bstrobel/fmtransmitter/pcb/FMTransmitterRaspi/FMTransmitterRaspi.kicad_pcb

## KiCad design pcb/FMTransmitterRaspi/FMTransmitterRaspi.kicad_pcb (2026-10-04)

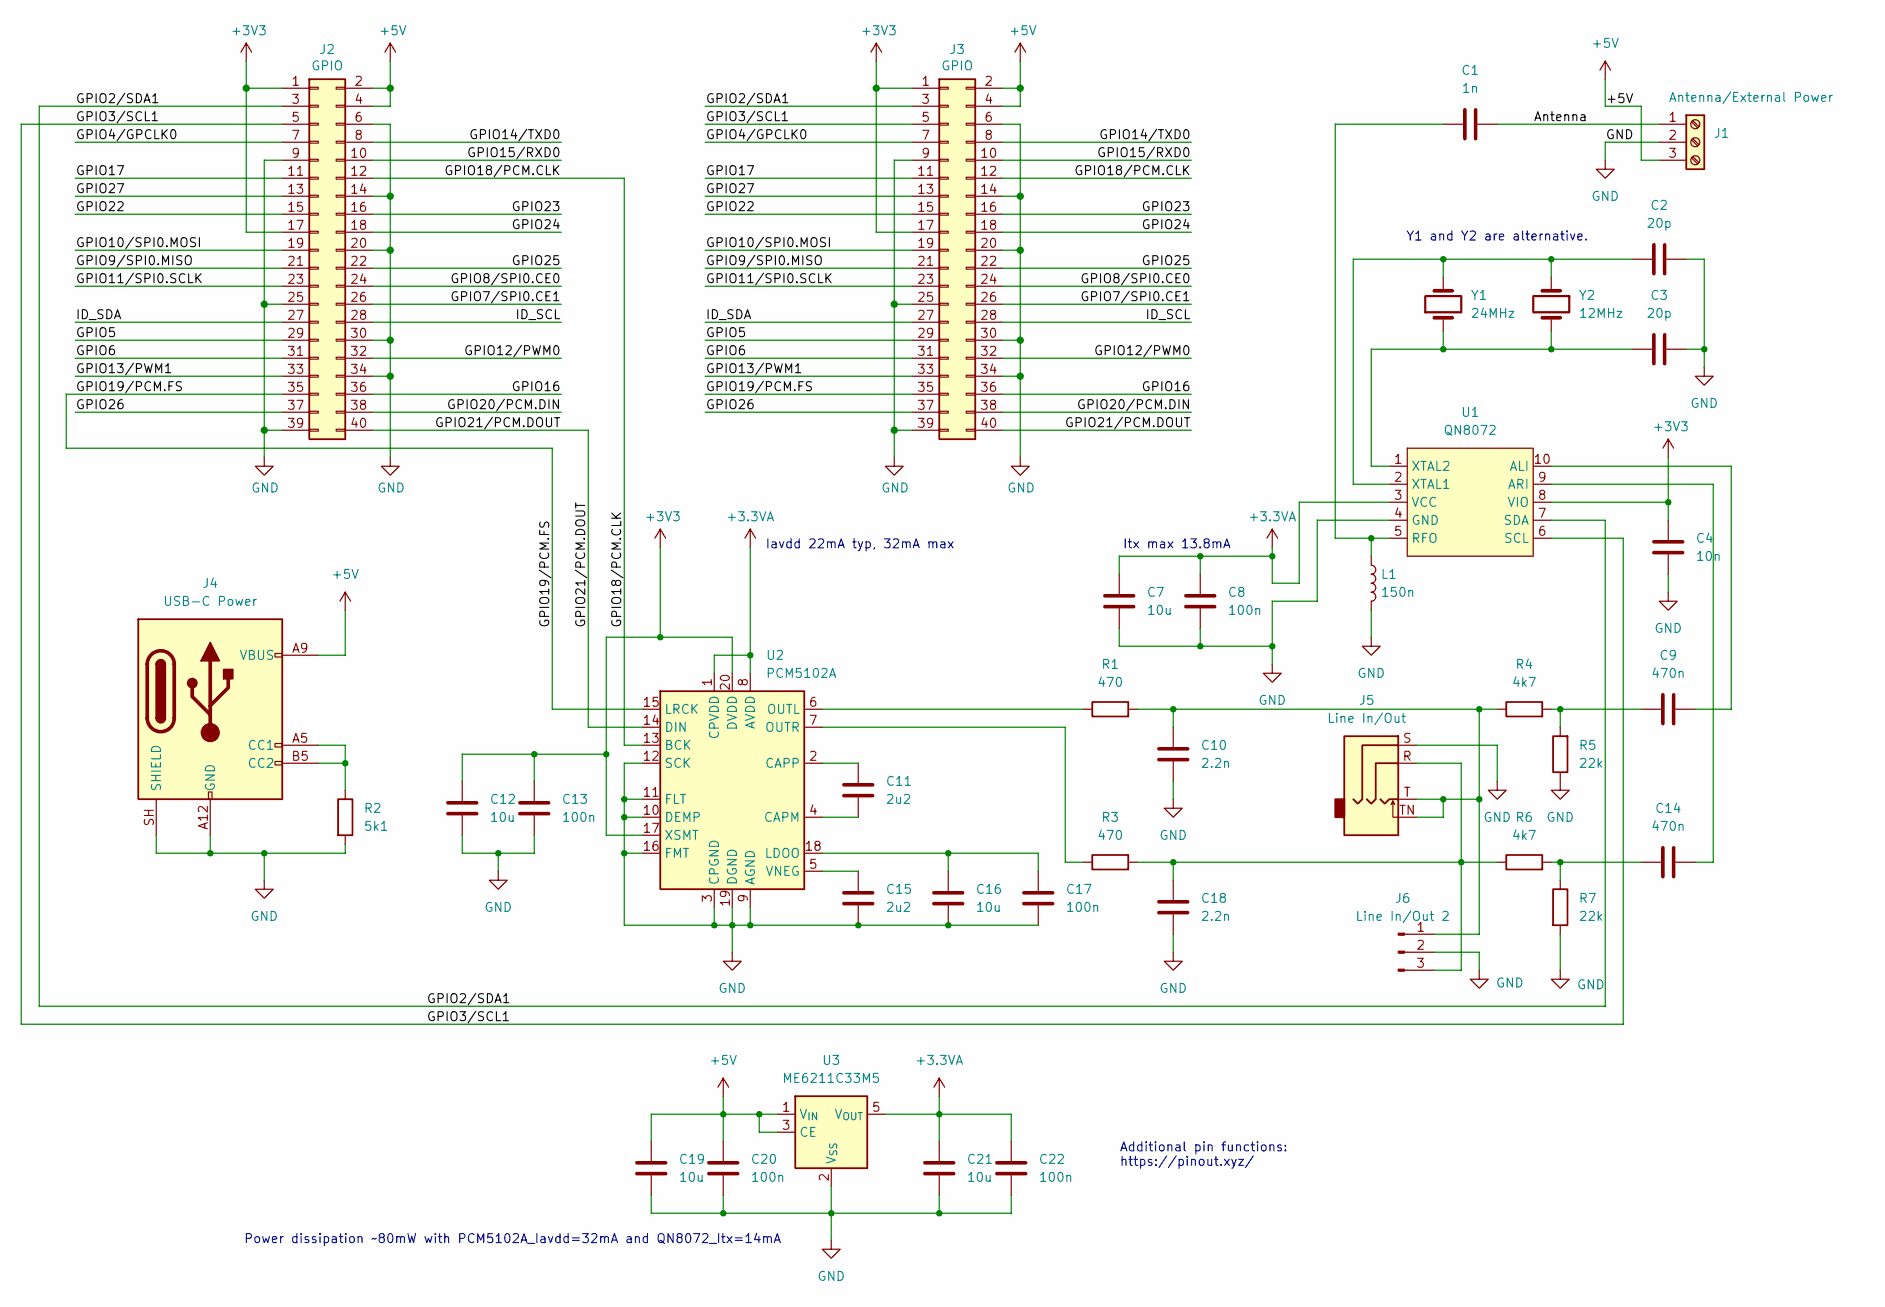
[picture p1: schematic FMTransmitterRaspi.kicad_sch]

Parts:
C1: 1n; C_0603_1608Metric_Pad1.08x0.95mm_HandSolder
C2, C3: 20p; C_0603_1608Metric_Pad1.08x0.95mm_HandSolder
C4: 10n; C_0603_1608Metric_Pad1.08x0.95mm_HandSolder
C7, C12, C16: 10u; C_0603_1608Metric_Pad1.08x0.95mm_HandSolder
C8, C13, C17, C20, C22: 100n; C_0603_1608Metric_Pad1.08x0.95mm_HandSolder
C9, C14: 470n; C_Rect_L7.2mm_W3.5mm_P5.00mm
C10, C18: 2.2n; C_Rect_L9.0mm_W2.7mm_P7.50mm_MKT
C11, C15: 2u2; C_0603_1608Metric_Pad1.08x0.95mm_HandSolder
C19, C21: 10u; C_0805_2012Metric_Pad1.18x1.45mm_HandSolder
J1: Antenna/External Power; TerminalBlock_MaiXu_MX126-5.0-03P_1x03_P5.00mm
J2: GPIO; PinSocket_2x20_P2.54mm_Vertical
J3: GPIO; PinHeader_2x20_P2.54mm_Vertical
J4: USB-C Power; USB_C_Receptacle_HRO_TYPE-C-31-M-17
J5: Line In/Out; Jack_3.5mm_PJ327A_Horizontal
J6: Line In/Out 2; PinHeader_1x03_P2.54mm_Vertical
L1: 150n; L_0805_2012Metric_Pad1.05x1.20mm_HandSolder
R1, R3: 470; R_0603_1608Metric_Pad0.98x0.95mm_HandSolder
R2: 5k1; R_0603_1608Metric_Pad0.98x0.95mm_HandSolder
R4, R6: 4k7; R_0603_1608Metric_Pad0.98x0.95mm_HandSolder
R5, R7: 22k; R_0603_1608Metric_Pad0.98x0.95mm_HandSolder
U1: QN8072; MSOP-10_3x3mm_P0.5mm
U2: PCM5102A; TSSOP-20_4.4x6.5mm_P0.65mm
U3: ME6211C33M5; SOT-23-5
Y1: 24MHz; Crystal_HC18-U_Vertical
Y2: 12MHz; Crystal_DS15_D1.5mm_L5.0mm_Horizontal_1EP_style1

Connections:
+3.3VA: C7.1, C8.1, C21.1, C22.1, U1.3 (VCC), U2.1 (CPVDD), U2.8 (AVDD), U3.5 (V_{OUT})
+3V3: C4.1, C12.1, C13.1, J2.1, J2.17, J3.1, J3.17, U1.8 (VIO), U2.17 (XSMT), U2.20 (DVDD)
+5V: C19.1, C20.1, J1.3, J2.2, J2.4, J3.2, J3.4, J4.A9 (VBUS), J4.B9 (VBUS), U3.1 (V_{IN}), U3.3 (CE)
/Antenna: C1.2, J1.1
/GPIO2/SDA1: J2.3, J3.3, U1.7 (SDA)
/GPIO3/SCL1: J2.5, J3.5, U1.6 (SCL)
/GPIO4/GPCLK0: J2.7, J3.7
/GPIO5: J2.29, J3.29
/GPIO6: J2.31, J3.31
/GPIO7/SPI0.CE1: J2.26, J3.26
/GPIO8/SPI0.CE0: J2.24, J3.24
/GPIO9/SPI0.MISO: J2.21, J3.21
/GPIO10/SPI0.MOSI: J2.19, J3.19
/GPIO11/SPI0.SCLK: J2.23, J3.23
/GPIO12/PWM0: J2.32, J3.32
/GPIO13/PWM1: J2.33, J3.33
/GPIO14/TXD0: J2.8, J3.8
/GPIO15/RXD0: J2.10, J3.10
/GPIO16: J2.36, J3.36
/GPIO17: J2.11, J3.11
/GPIO18/PCM.CLK: J2.12, J3.12, U2.13 (BCK)
/GPIO19/PCM.FS: J2.35, J3.35, U2.15 (LRCK)
/GPIO20/PCM.DIN: J2.38, J3.38
/GPIO21/PCM.DOUT: J2.40, J3.40, U2.14 (DIN)
/GPIO22: J2.15, J3.15
/GPIO23: J2.16, J3.16
/GPIO24: J2.18, J3.18
/GPIO25: J2.22, J3.22
/GPIO26: J2.37, J3.37
/GPIO27: J2.13, J3.13
/ID_SCL: J2.28, J3.28
/ID_SDA: J2.27, J3.27
GND: C2.2, C3.2, C4.2, C7.2, C8.2, C10.2, C12.2, C13.2, C15.2, C16.2, C17.2, C18.2, C19.2, C20.2, C21.2, C22.2, J1.2, J2.6, J2.9, J2.14, J2.20, J2.25, J2.30, J2.34, J2.39, J3.6, J3.9, J3.14, J3.20, J3.25, J3.30, J3.34, J3.39, J4.A12 (GND), J4.B12 (GND), J4.SH (SHIELD), J5.S, J6.2, L1.2, R2.2, R5.1, R7.2, U1.4 (GND), U2.3 (CPGND), U2.9 (AGND), U2.10 (DEMP), U2.11 (FLT), U2.12 (SCK), U2.16 (FMT), U2.19 (DGND), U3.2 (V_{SS})
unnamed: C9.1, R4.2, R5.2
unnamed: C14.1, R6.2, R7.1
unnamed: J4.A5 (CC1), J4.B5 (CC2), R2.1
unnamed: C10.1, J5.T, J5.TN, J6.1, R1.2, R4.1
unnamed: C18.1, J5.R, J6.3, R3.2, R6.1
unnamed: C9.2, U1.10 (ALI)
unnamed: C14.2, U1.9 (ARI)
unnamed: C1.1, L1.1, U1.5 (RFO)
unnamed: C2.1, U1.2 (XTAL1), Y1.2, Y2.1
unnamed: C3.1, U1.1 (XTAL2), Y1.1, Y2.2
unnamed: C11.2, U2.4 (CAPM)
unnamed: C11.1, U2.2 (CAPP)
unnamed: C16.1, C17.1, U2.18 (LDOO)
unnamed: R1.1, U2.6 (OUTL)
unnamed: R3.1, U2.7 (OUTR)
unnamed: C15.1, U2.5 (VNEG)

Notes on the sheet:
Y1 and Y2 are alternative.
Itx max 13.8mA
Power dissipation ~80mW with PCM5102A_Iavdd=32mA and QN8072_Itx=14mA
Iavdd 22mA typ, 32mA max
Additional pin functions: https://pinout.xyz/

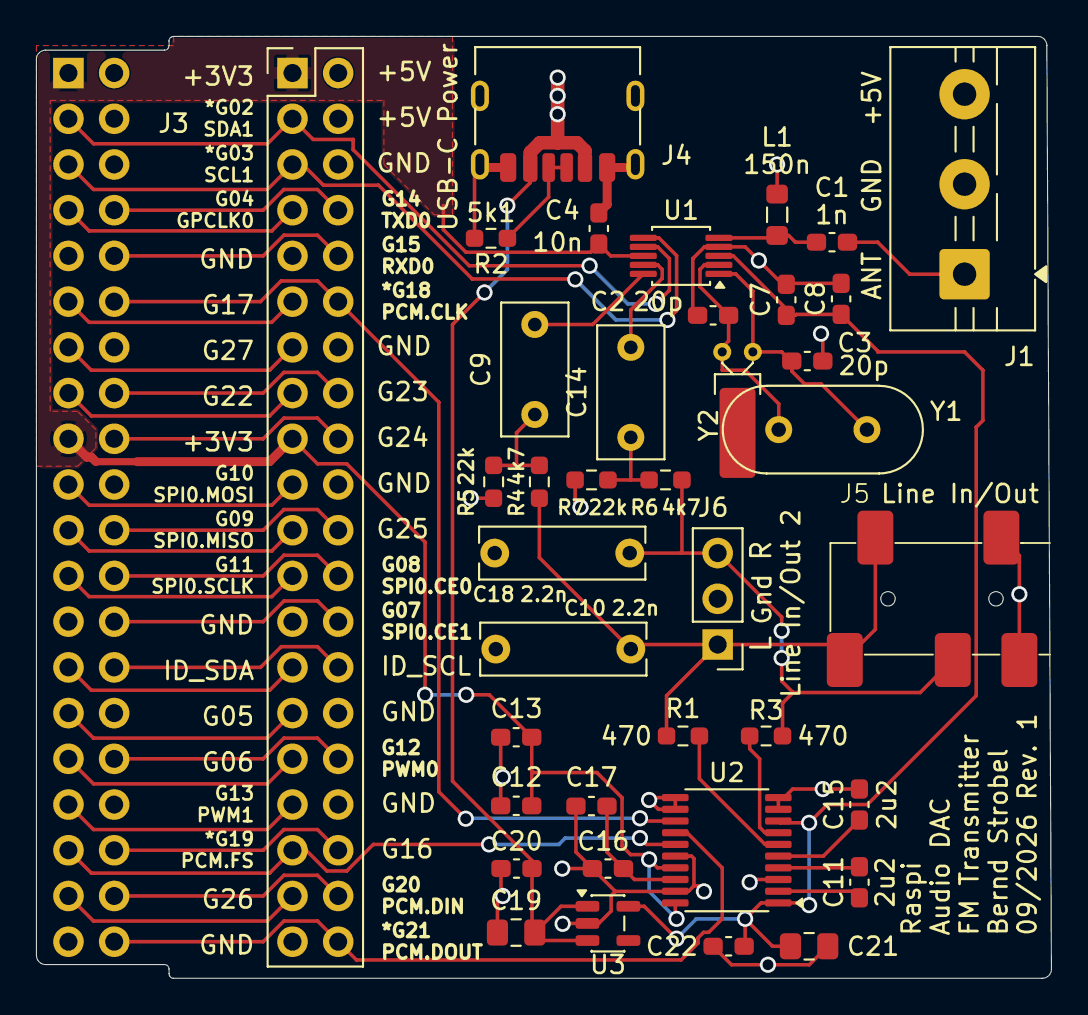
[picture p2: board FMTransmitterRaspi.kicad_pcb from above]

Board: 2 copper layers, 56.4 x 52.3 mm, 39 parts (1 on the bottom side), 49 nets.
