bstrobel/fmtransmitter/(commit log)

2026-08-21 Kicad project added, schematic 80% complete, a few footprints, no pcb yet
    [FMTransmitterRaspi.kicad_pcb, FMTransmitterRaspi.kicad_sch]
2026-08-23 Added DC blocking caps at the QN8027 input
    [FMTransmitterRaspi.kicad_sch]
2026-09-05 Ready for production
    [FMTransmitterRaspi.kicad_pcb, FMTransmitterRaspi.kicad_sch]
2026-09-05 Ready for production - final :)
    [FMTransmitterRaspi.kicad_pcb]
2026-09-05 Gerbers generated, sent to JLBPCB
    [FMTransmitterRaspi-B_Cu.gbl, FMTransmitterRaspi-B_Mask.gbs, FMTransmitterRaspi-B_Paste.gbp, FMTransmitterRaspi-B_Silkscreen.gbo, FMTransmitterRaspi-Edge_Cuts.gm1, FMTransmitterRaspi-F_Cu.gtl, FMTransmitterRaspi-F_Mask.gts, FMTransmitterRaspi-F_Paste.gtp]
2026-09-20 corrected wrong symbol of qn8027, too wide board shape
    [FMTransmitterRaspi.kicad_pcb, FMTransmitterRaspi.kicad_sch]
2026-09-20 pcb beautified
    [FMTransmitterRaspi.kicad_pcb, FMTransmitterRaspi.kicad_sch]
2026-09-25 added voltage divider between pcm5102 and qn8027
    [FMTransmitterRaspi.kicad_pcb, FMTransmitterRaspi.kicad_sch]
2026-09-25 forgot to route 2 connections...
    [FMTransmitterRaspi.kicad_pcb]
2026-09-25 revised board width, zones configuration
    [FMTransmitterRaspi.kicad_pcb]
2026-10-04 pcbs ordered
2026-10-18 Rin-Wert im schematic nochmal korrigiert
